kuro68k/xrng2/hardware/xrng2.pdf

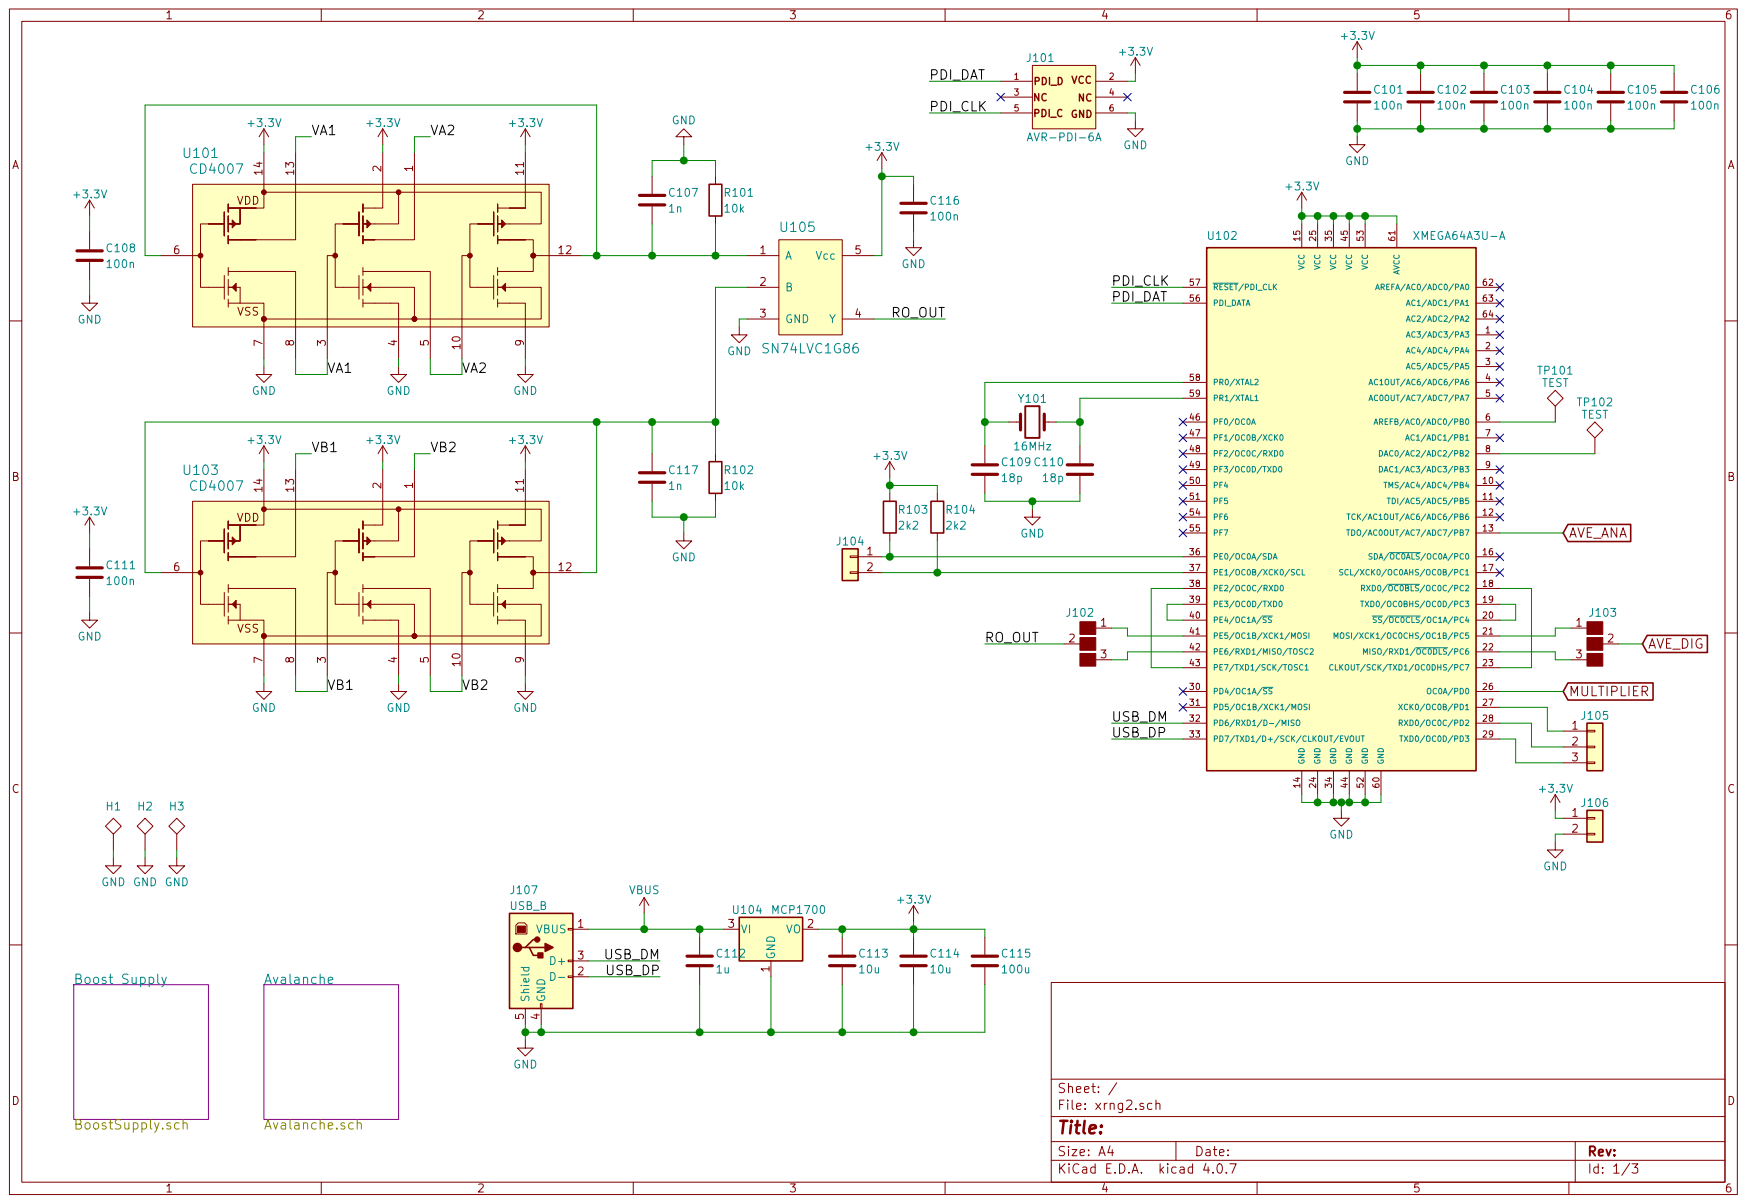
[picture p1: page 1]

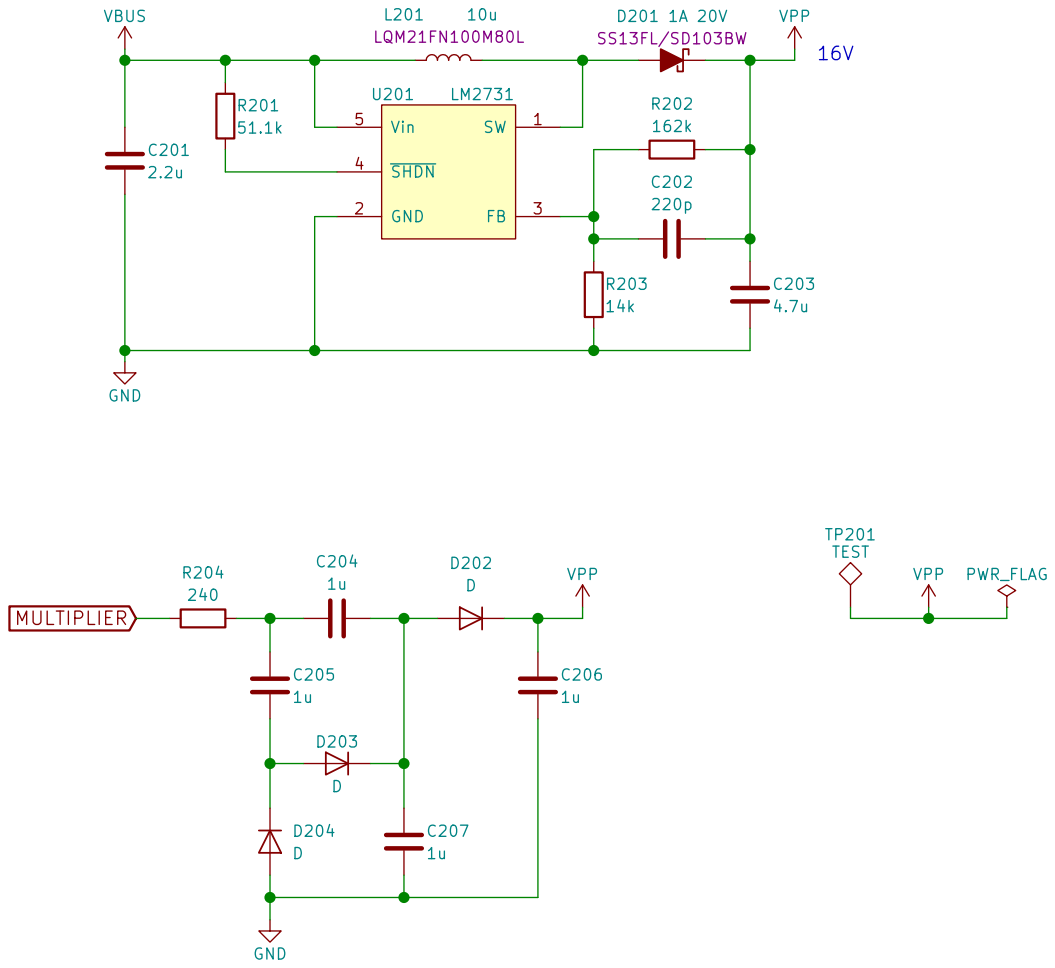
[picture p2: page 2]

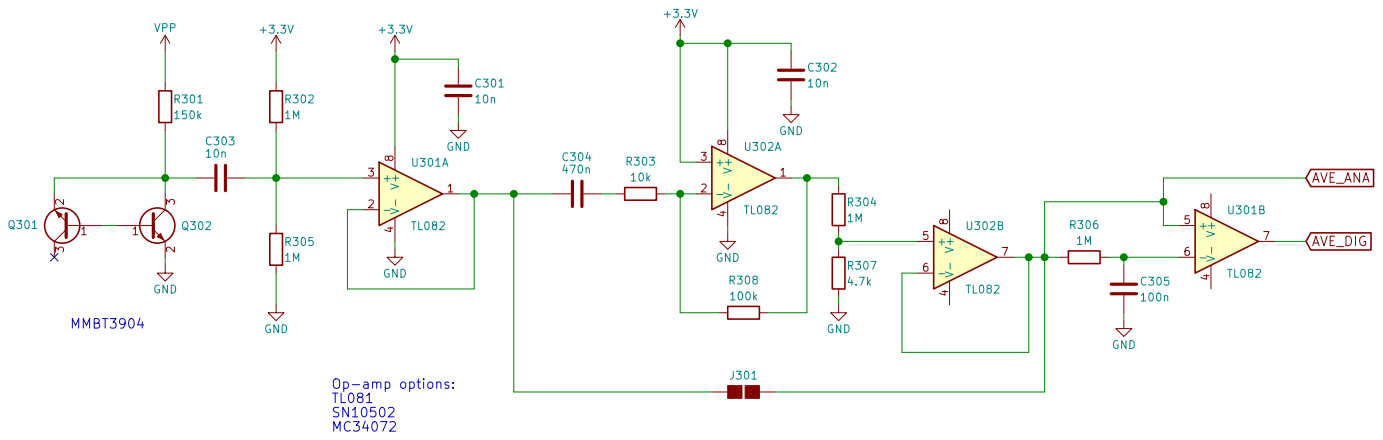
[picture p3: page 3]
