kuro68k/xrng2/hardware/xrng2.kicad_pcb

## KiCad design hardware/xrng2.kicad_pcb (2018-06-21)

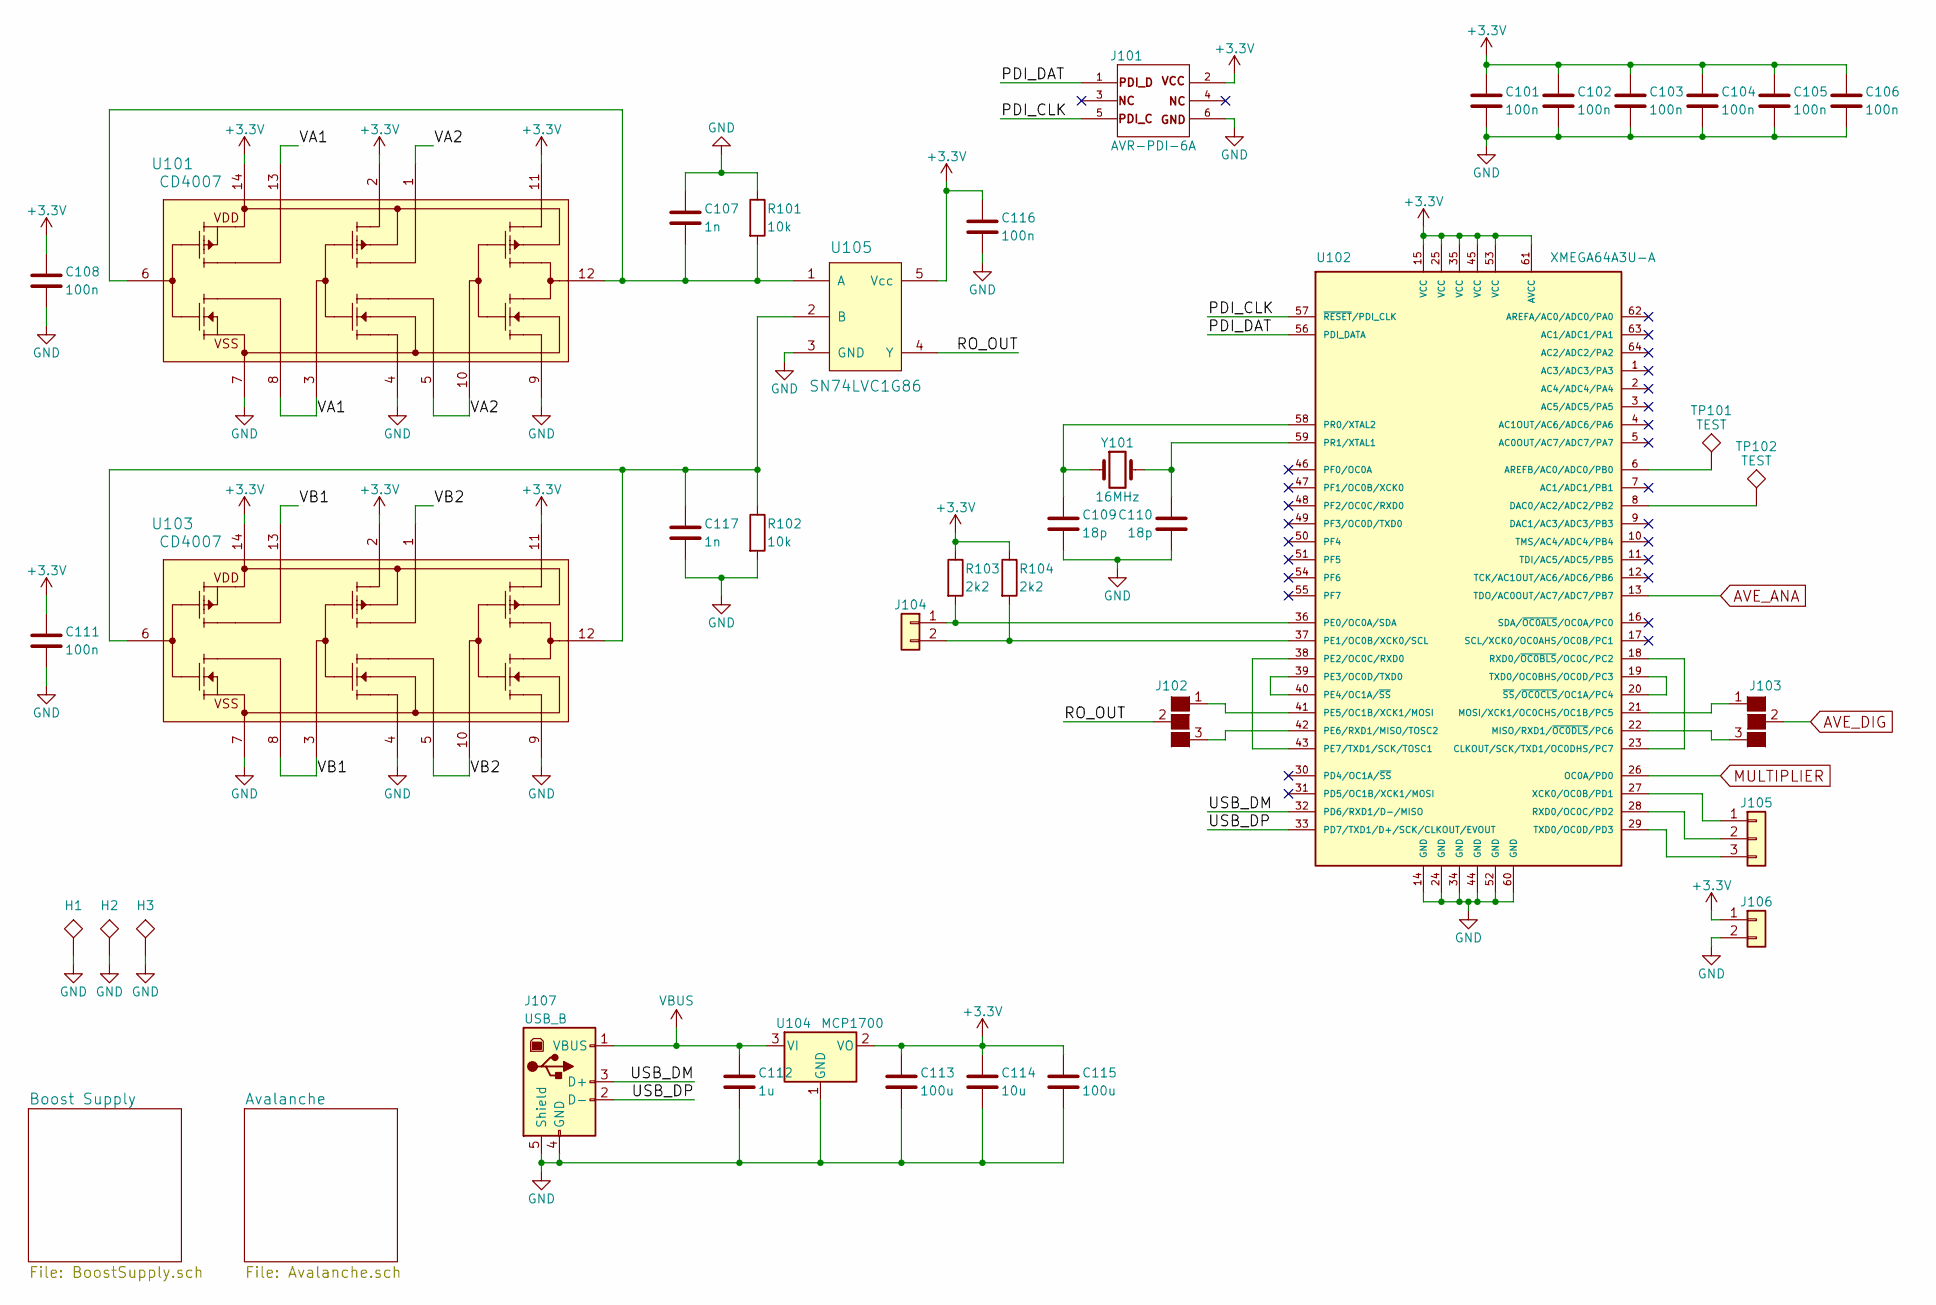
[picture p4: schematic xrng2.sch]

Parts:
C101, C102, C103, C104, C105, C106, C108, C111, C116: 100n; C_0603_HandSoldering
C107, C117: 1n; C_0603_HandSoldering
C109, C110: 18p; C_0603_HandSoldering
C112: 1u; C_0603_HandSoldering
C113: 100u; C_0603_HandSoldering
C114: 10u; C_0603_HandSoldering
C115: 100u; C_0805_HandSoldering
H1, H2, H3: MOUNT; MountingHole_3.2mm_M3
J101: AVR-PDI-6A; Pin_Header_Straight_2x03_Pitch2.54mm
J102, J103: GS3
J104, J106: Conn_01x02; Pin_Header_Straight_1x02_Pitch2.54mm
J105: Conn_01x03; Pin_Header_Straight_1x03_Pitch2.54mm
J107: USB_B
R101, R102: 10k; R_0603_HandSoldering
R103, R104: 2k2; R_0603_HandSoldering
TP101, TP102: TEST; Measurement_Point_Square-SMD-Pad_Big
U101, U103: CD4007; SOIC-14_3.9x8.7mm_Pitch1.27mm
U102: XMEGA64A3U-A; TQFP-64_14x14mm_Pitch0.8mm
U104: MCP1700; SOT-23
U105: SN74LVC1G86; SOT-23-5
Y101: 16MHz; SMD_Crystal_Multi_QC6CB_7A_ABM7

Connections:
+3V3: C101.1, C102.1, C103.1, C104.1, C105.1, C106.1, C108.1, C111.1, C113.1, C114.1, C115.1, C116.1, J101.2, J106.1, R103.1, R104.1, U101.2 (2Sp), U101.11 (3Sp), U101.14 (VDD), U102.15 (VCC), U102.25 (VCC), U102.35 (VCC), U102.45 (VCC), U102.53 (VCC), U102.61 (AVCC), U103.2 (2Sp), U103.11 (3Sp), U103.14 (VDD), U104.2 (VO), U105.5 (Vcc); also elsewhere on the board
/PDI_CLK: J101.5, U102.57 (~RESET~/PDI_CLK)
/PDI_DAT: J101.1, U102.56 (PDI_DATA)
/RO_OUT: J102.2 (G2), U105.4 (Y)
/USB_DM: J107.3 (D+), U102.32 (PD6/RXD1/D-/MISO)
/USB_DP: J107.2 (D-), U102.33 (PD7/TXD1/D+/SCK/CLKOUT/EVOUT)
/VA1: U101.3 (2A), U101.8 (1Dn), U101.13 (1Dp)
/VA2: U101.1 (2Dp), U101.5 (2Dn), U101.10 (3A)
/VB1: U103.3 (2A), U103.8 (1Dn), U103.13 (1Dp)
/VB2: U103.1 (2Dp), U103.5 (2Dn), U103.10 (3A)
AVE_ANA: U102.13 (TDO/AC0OUT/AC7/ADC7/PB7); also elsewhere on the board
AVE_DIG: J103.2 (G2); also elsewhere on the board
GND: C101.2, C102.2, C103.2, C104.2, C105.2, C106.2, C107.1, C108.2, C109.2, C110.2, C111.2, C112.2, C113.2, C114.2, C115.2, C116.2, C117.2, H1.1, H2.1, H3.1, J101.6, J106.2, J107.4 (GND), J107.5 (Shield), R101.1, R102.2, U101.4 (2Sn), U101.7 (VSS), U101.9 (3Sn), U102.14 (GND), U102.24 (GND), U102.34 (GND), U102.44 (GND), U102.52 (GND), U102.60 (GND), U103.4 (2Sn), U103.7 (VSS), U103.9 (3Sn), U104.1 (GND), U105.3 (GND); also elsewhere on the board
MULTIPLIER: U102.26 (OC0A/PD0); also elsewhere on the board
unnamed: C107.2, R101.2, U101.6 (1A), U101.12 (3Y), U105.1 (A)
unnamed: C109.1, U102.58 (PR0/XTAL2), Y101.1
unnamed: C110.1, U102.59 (PR1/XTAL1), Y101.2
unnamed: C117.1, R102.1, U103.6 (1A), U103.12 (3Y), U105.2 (B)
unnamed: J102.1 (G1), U102.41 (PE5/OC1B/XCK1/MOSI)
unnamed: J102.3 (G3), U102.42 (PE6/RXD1/MISO/TOSC2)
unnamed: J103.1 (G1), U102.21 (MOSI/XCK1/OC0CHS/OC1B/PC5)
unnamed: J103.3 (G3), U102.22 (MISO/RXD1/~OC0DLS~/PC6)
unnamed: J104.1, R103.2, U102.36 (PE0/OC0A/SDA)
unnamed: J104.2, R104.2, U102.37 (PE1/OC0B/XCK0/SCL)
unnamed: J105.1, U102.27 (XCK0/OC0B/PD1)
unnamed: J105.2, U102.28 (RXD0/OC0C/PD2)
unnamed: J105.3, U102.29 (TXD0/OC0D/PD3)
unnamed: TP101.1, U102.6 (AREFB/AC0/ADC0/PB0)
unnamed: TP102.1, U102.8 (DAC0/AC2/ADC2/PB2)
unnamed: U102.18 (RXD0/~OC0BLS~/OC0C/PC2), U102.23 (CLKOUT/SCK/TXD1/OC0DHS/PC7)
unnamed: U102.19 (TXD0/OC0BHS/OC0D/PC3), U102.20 (~SS~/~OC0CLS~/OC1A/PC4)
unnamed: U102.38 (PE2/OC0C/RXD0), U102.43 (PE7/TXD1/SCK/TOSC1)
unnamed: U102.39 (PE3/OC0D/TXD0), U102.40 (PE4/OC1A/~SS~)
VBUS: C112.1, J107.1 (VBUS), U104.3 (VI); also elsewhere on the board

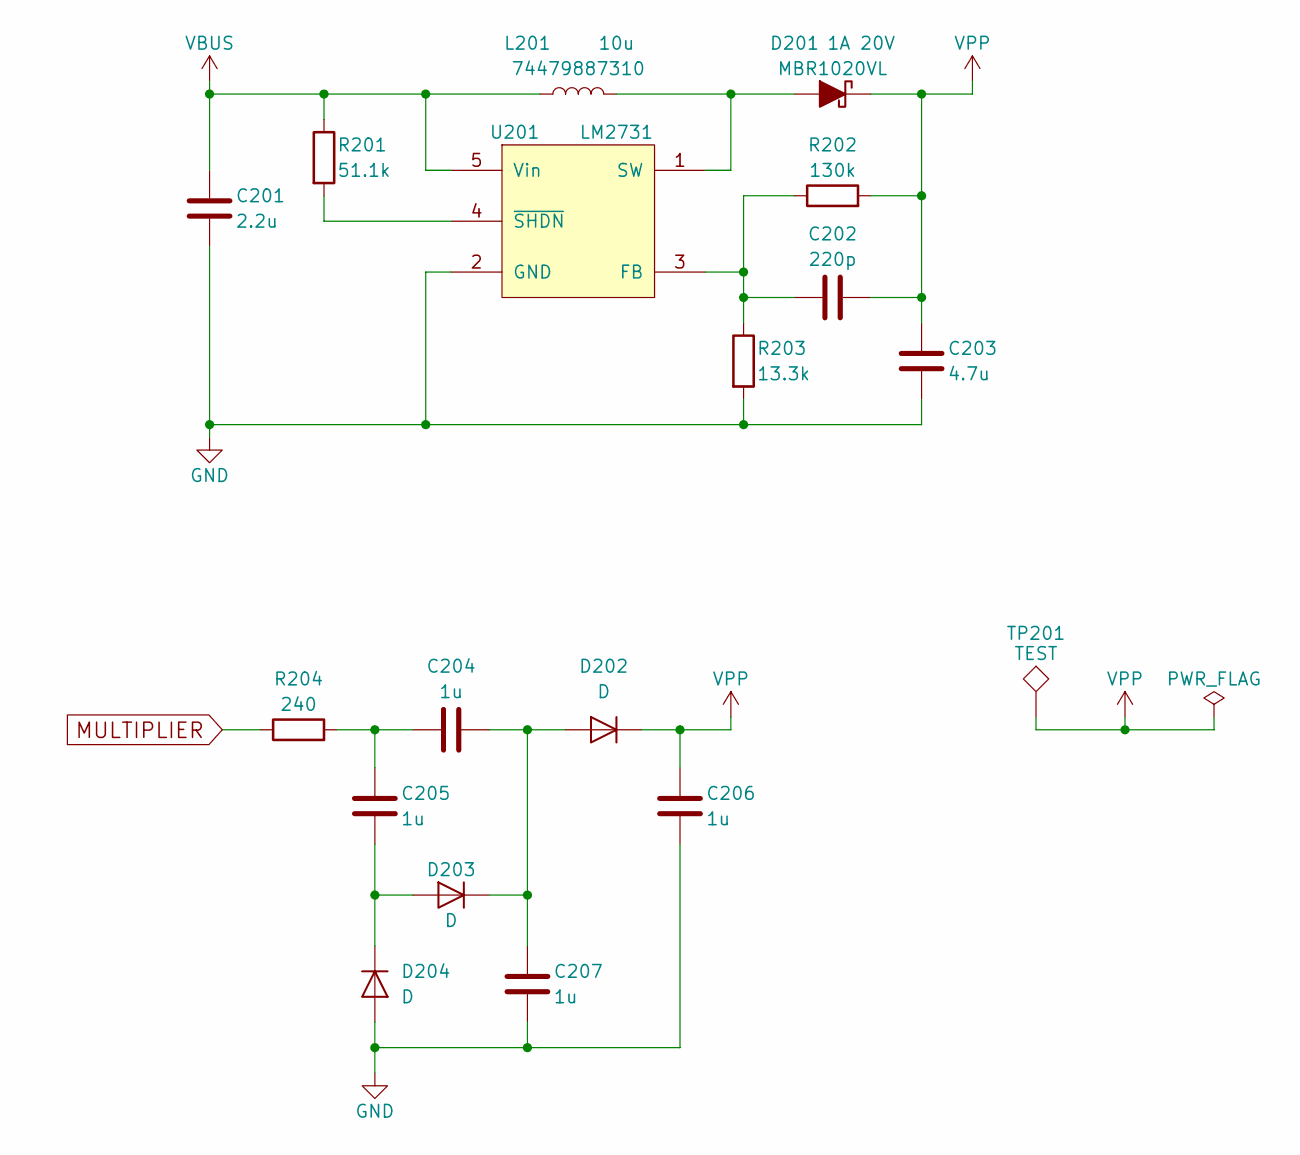
[picture p5: schematic BoostSupply.sch]

Parts:
C201: 2.2u; C_0603_HandSoldering
C202: 220p; C_0603_HandSoldering
C203: 4.7u; C_0805_HandSoldering
C204, C205, C206, C207: 1u; C_0603_HandSoldering
D201: 1A 20V; D_SOD-123F
D202, D203, D204: D; D_SOD-523
L201: 10u; R_0805_HandSoldering
R201: 51.1k; R_0603_HandSoldering
R202: 130k; R_0603_HandSoldering
R203: 13.3k; R_0603_HandSoldering
R204: 240; R_0603_HandSoldering
TP201: TEST; Measurement_Point_Square-SMD-Pad_Big
U201: LM2731; SOT-23-5

Connections:
GND: C201.2, C203.2, C206.2, C207.2, D204.2 (A), R203.2, U201.2 (GND); also elsewhere on the board
MULTIPLIER: R204.1; also elsewhere on the board
unnamed: C202.1, R202.1, R203.1, U201.3 (FB)
unnamed: C204.1, C205.1, R204.2
unnamed: C204.2, C207.1, D202.2 (A), D203.1 (K)
unnamed: C205.2, D203.2 (A), D204.1 (K)
unnamed: D201.2 (A), L201.1, U201.1 (SW)
unnamed: R201.2, U201.4 (~SHDN)
VBUS: C201.1, L201.2, R201.1, U201.5 (Vin); also elsewhere on the board
VPP: C202.2, C203.1, C206.1, D201.1 (K), D202.1 (K), R202.2, TP201.1; also elsewhere on the board

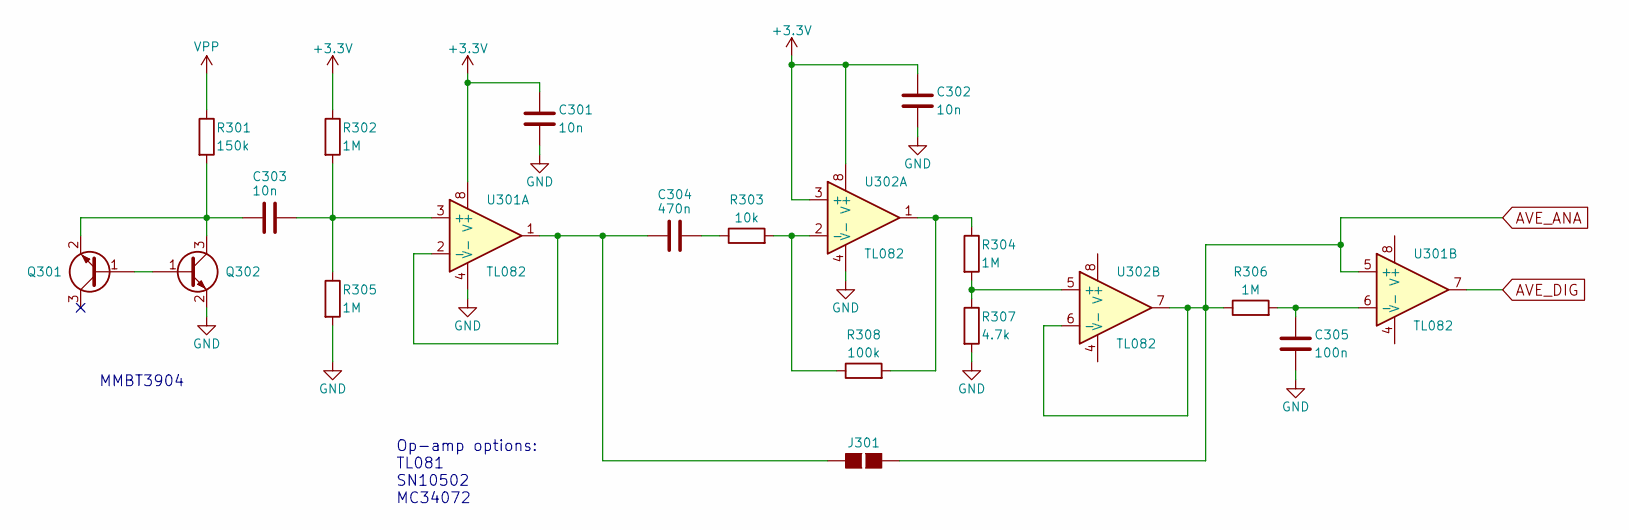
[picture p6: schematic Avalanche.sch]

Parts:
C301, C302, C303: 10n; C_0603_HandSoldering
C304: 470n; C_0603_HandSoldering
C305: 100n; C_0603_HandSoldering
J301: GS2
Q301, Q302: MMBT3904; SOT-23
R301: 150k; R_0603_HandSoldering
R302, R304, R305, R306: 1M; R_0603_HandSoldering
R303: 10k; R_0603_HandSoldering
R307: 4.7k; R_0603_HandSoldering
R308: 100k; R_0603_HandSoldering
U301, U302: TL082; SOIC-8_3.9x4.9mm_Pitch1.27mm

Connections:
+3V3: C301.1, C302.1, R302.1, U301.8 (V+), U302.3 (+), U302.8 (V+); also elsewhere on the board
AVE_ANA: J301.2 (G2), R306.1, U301.5 (+), U302.6 (-), U302.7; also elsewhere on the board
AVE_DIG: U301.7; also elsewhere on the board
GND: C301.2, C302.2, C305.2, Q302.2 (E), R305.2, R307.2, U301.4 (V-), U302.4 (V-); also elsewhere on the board
unnamed: C303.1, Q301.2 (E), Q302.3 (C), R301.2
unnamed: C303.2, R302.2, R305.1, U301.3 (+)
unnamed: C304.1, J301.1 (G1), U301.1, U301.2 (-)
unnamed: C304.2, R303.1
unnamed: C305.1, R306.2, U301.6 (-)
unnamed: Q301.1 (B), Q302.1 (B)
unnamed: R303.2, R308.1, U302.2 (-)
unnamed: R304.1, R308.2, U302.1
unnamed: R304.2, R307.1, U302.5 (+)
VPP: R301.1; also elsewhere on the board

Notes on the sheet:
MMBT3904
Op-amp options: TL081 SN10502 MC34072

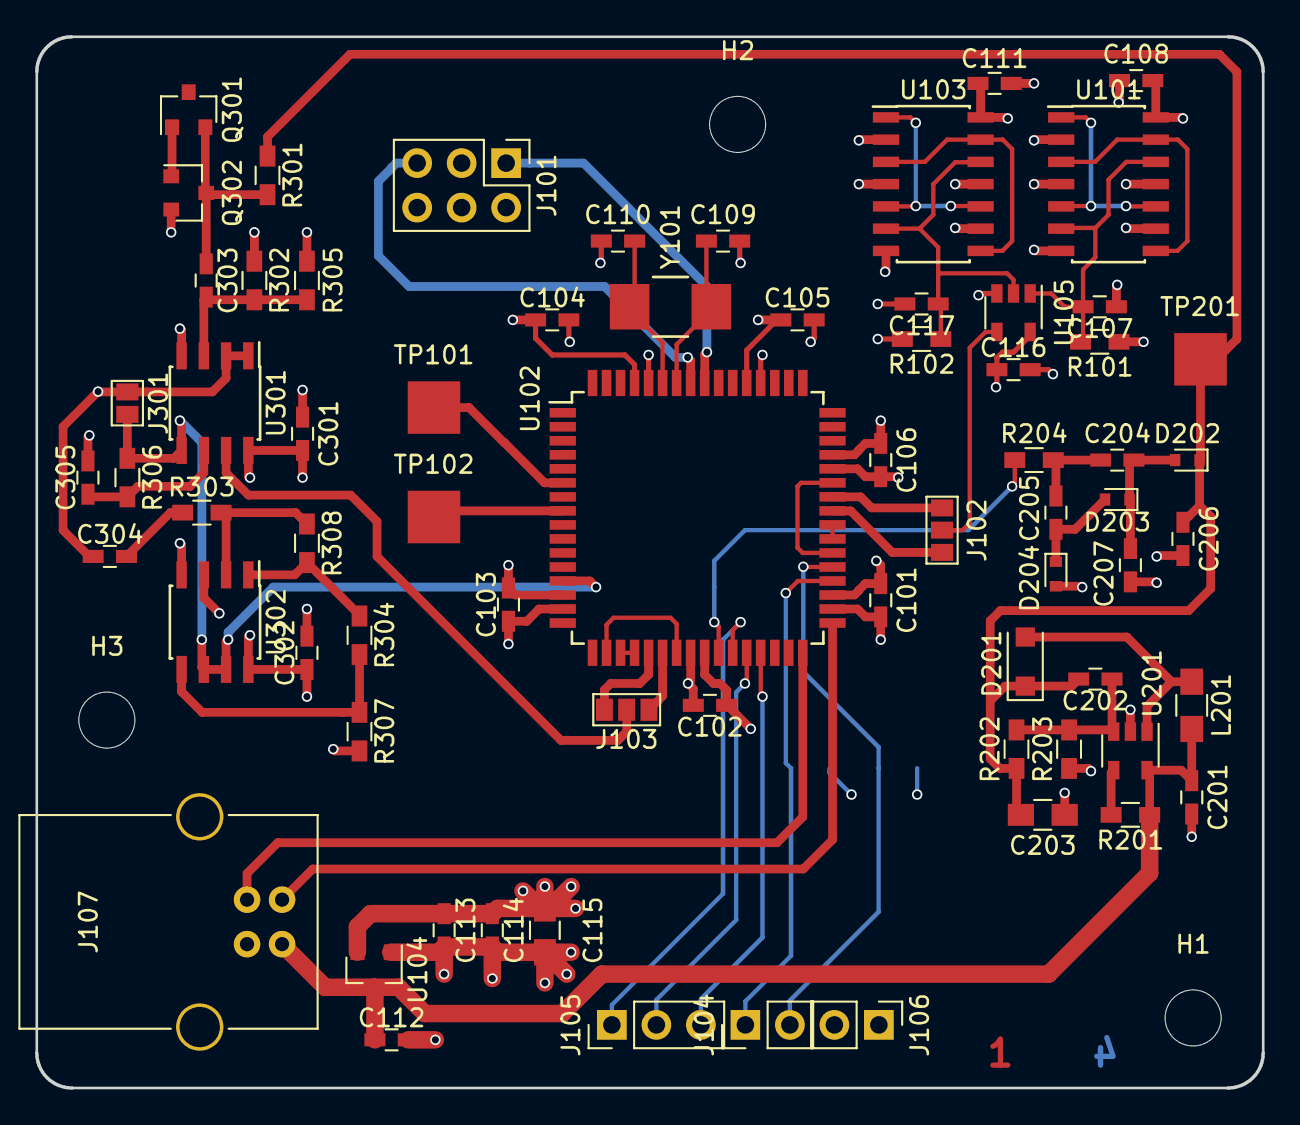
[picture p7: board xrng2.kicad_pcb from above]

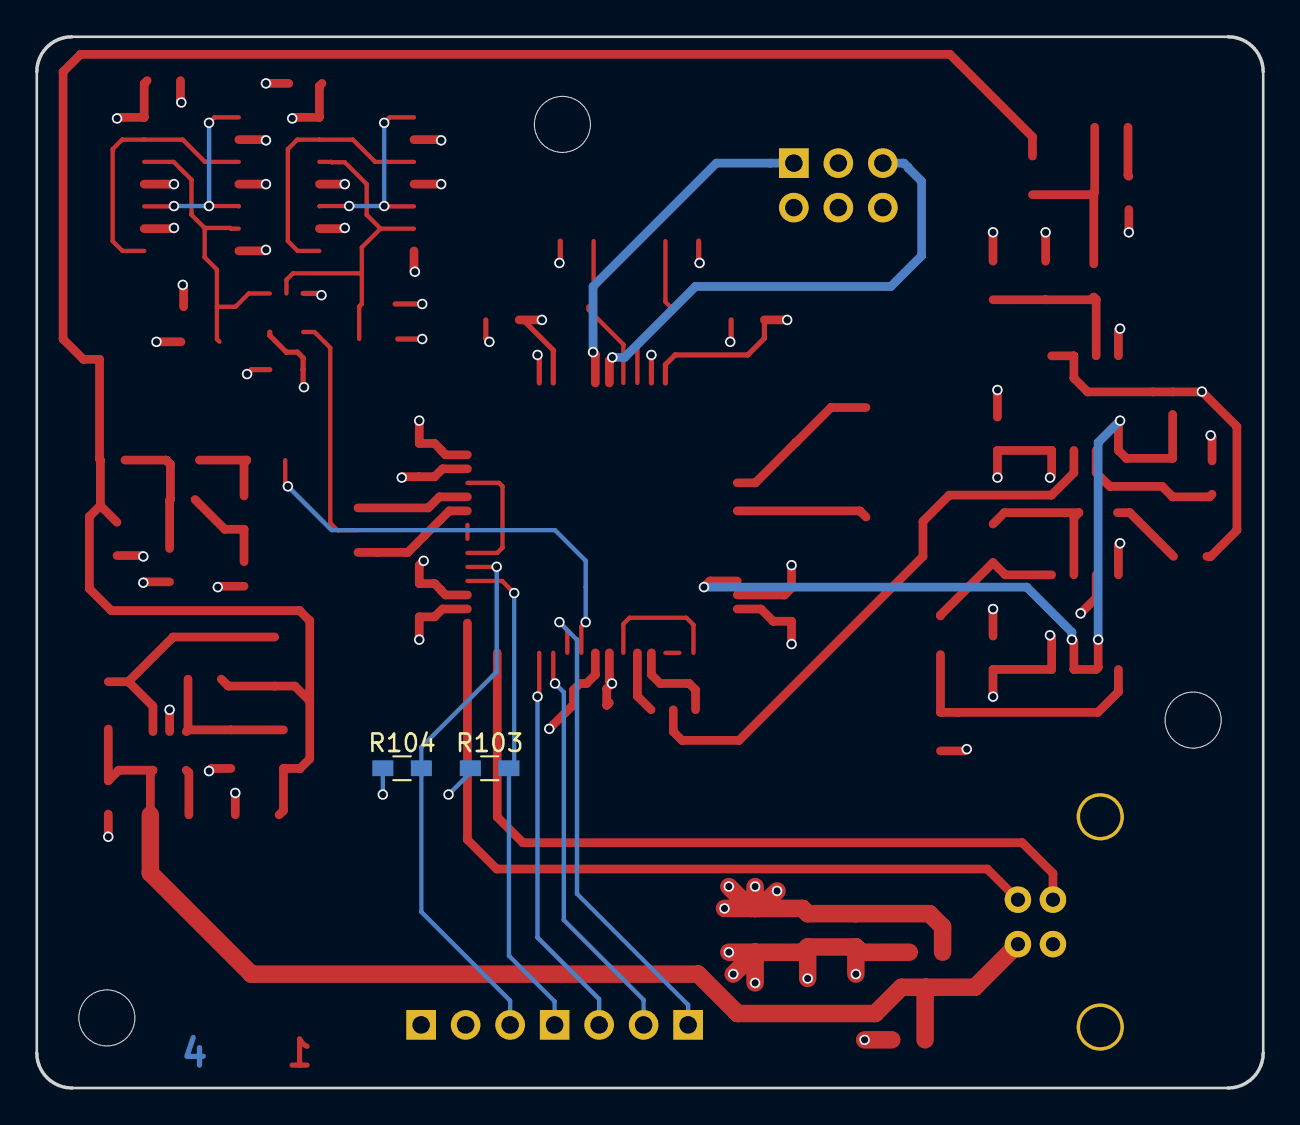
[picture p8: board xrng2.kicad_pcb from below]

Board: 4 copper layers, 70.0 x 60.0 mm, 75 parts (2 on the bottom side), 50 nets.
