kuro68k/xrng2/(commit log)

2018-06-18 Minimized balancing circuit
2018-06-18 IDs, footprints, DRC
    [Avalanche.sch, BoostSupply.sch, xrng2.sch]
2018-06-18 Corrected ring oscillator wiring
    [xrng2.sch]
2018-06-18 Design rules for Seeed
    [xrng2.kicad_pcb]
2018-06-18 Changed cap to 0805
    [BoostSupply.sch]
2018-06-18 Sub circuit layouts
    [xrng2.kicad_pcb]
2018-06-18 Dimensions and layout
    [xrng2.kicad_pcb]
2018-06-18 Tracking finished
    [xrng2.kicad_pcb]
2018-06-19 DRC OK
    [xrng2.kicad_pcb]
2018-06-19 F.Fab clean-up
    [xrng2.kicad_pcb]
2018-06-19 Corrected layer for silk text
    [xrng2.kicad_pcb]
2018-06-19 I2C on expansion header
    [xrng2.sch]
2018-06-19 Pull-ups for I2C
    [xrng2.sch]
2018-06-19 I2C on expansion
    [xrng2.kicad_pcb]
2018-06-19 Silk labels
    [xrng2.kicad_pcb]
2018-06-19 Silkscreen outlines
    [xrng2.kicad_pcb]
2018-06-19 Outline corrections
    [xrng2.kicad_pcb]
2018-06-19 C112 outline
    [xrng2.kicad_pcb]
2018-06-19 Mounting holes
    [Avalanche.sch, BoostSupply.sch, xrng2.sch]
2018-06-19 Layer IDs
    [xrng2.kicad_pcb]
2018-06-19 ident text
    [xrng2.kicad_pcb]
2018-06-19 Additional silk
    [xrng2.kicad_pcb]
2018-06-19 Rounded corners off
    [xrng2.kicad_pcb]
2018-06-21 Added BOM (kibom)
2018-06-21 XOR mixer
    [xrng2.sch]
2018-06-21 Corrected C113 value
    [xrng2.sch]
2018-06-21 16V output parts
    [BoostSupply.sch]
2018-08-16 PDF schematic
